YeiGonzalez/Project1_power_supply/README.md

# Project1_power_supply
This project contains the main file for the altium project for the LAB power supply
