YeiGonzalez/Project1_power_supply/Documentacion/HBLD_Fuente_Multisalida.drawio.png

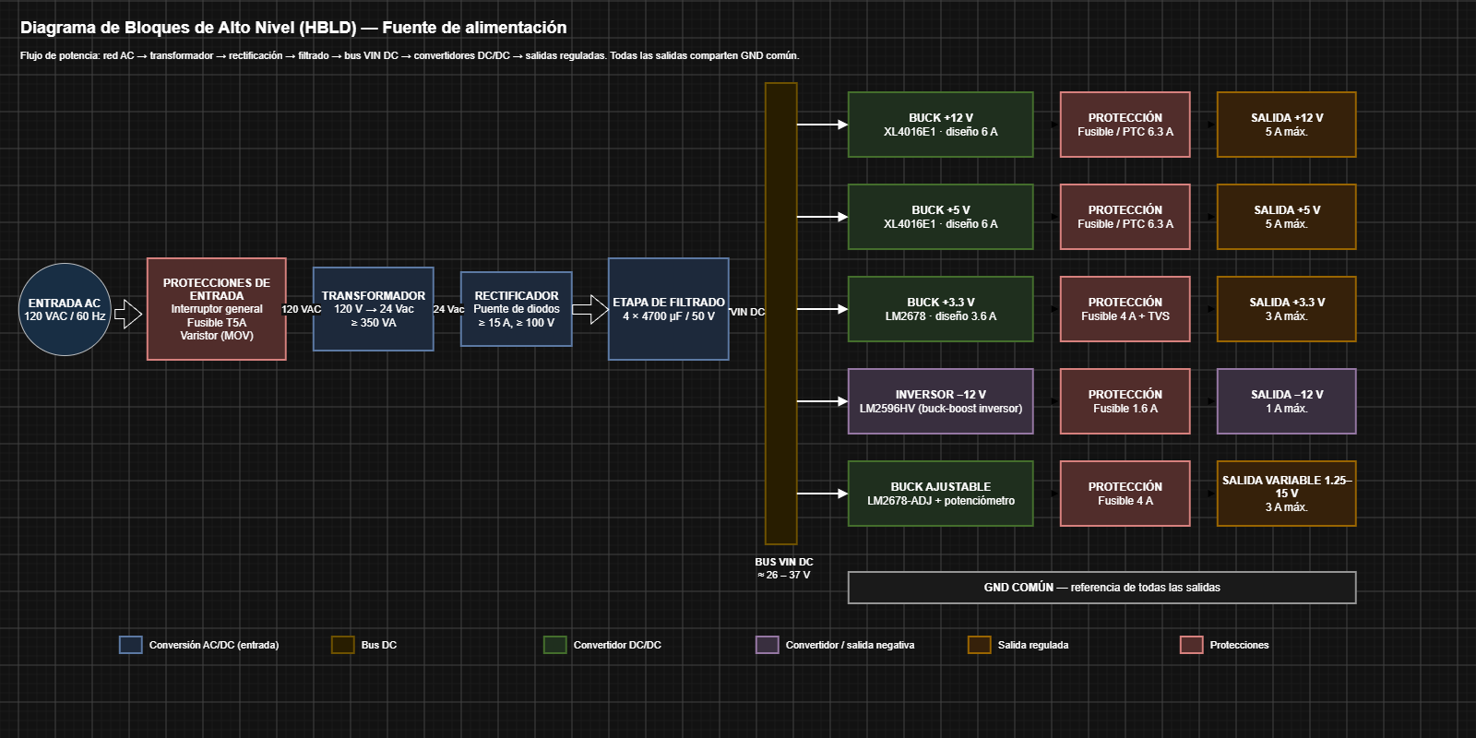
Documentacion/HBLD_Fuente_Multisalida.drawio.png
