YeiGonzalez/Project1_power_supply/Documentacion/HBLD_fuente_multisalida.png

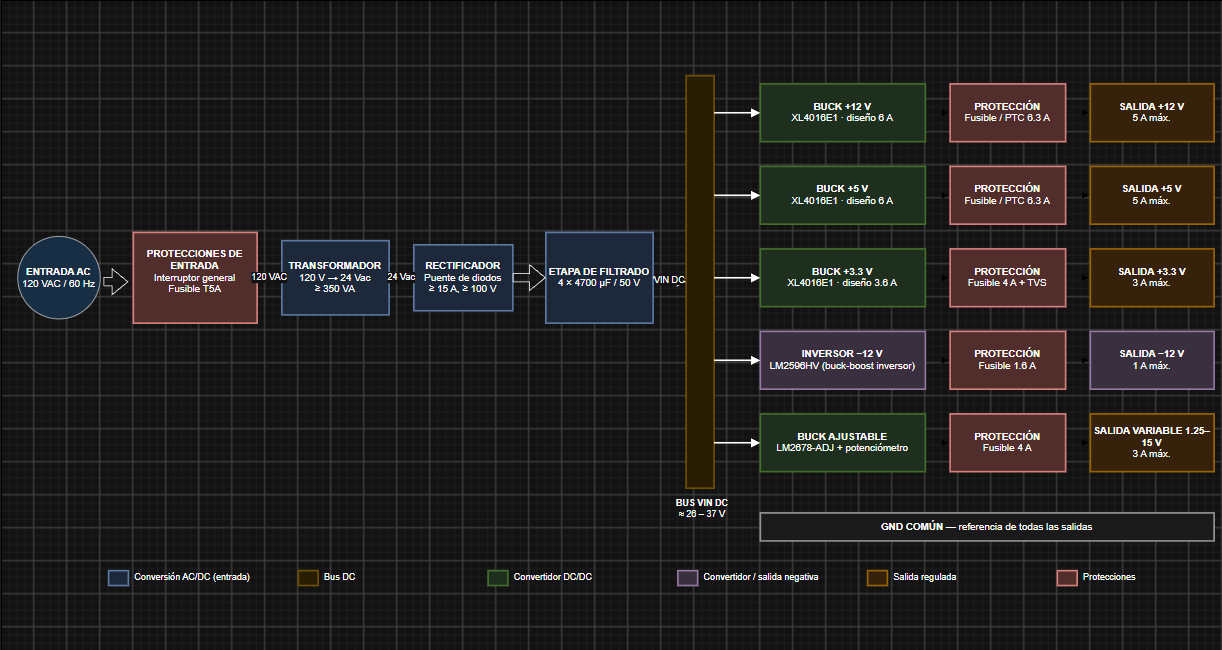
Documentacion/HBLD_fuente_multisalida.png
