YeiGonzalez/Project1_power_supply/Templates/BOM_Template_Atherion.xlsx

Project: | Field=GlobalProjectName |  | Company: | Platia
Board: | Field=GlobalBoardName |  | Date: | Field=GlobalReleaseDate
Revision: | Field=GlobalRevisionVersion |  | Total Quantity: | Field=TotalQuantity
Assembly Variant: | Field=VariantName
Column=Quantity | Column=Designator | Column=Description | Column=Value | Column=Comment | Column=Manufacturer | Column=Manufacturer Part Number | Column=Supplier 1 | Column=Supplier Part Number 1
