YeiGonzalez/Project1_power_supply/Documentacion/Documentacion_Fuente_Multisalida.xlsx

Sheet: Especificaciones
Especificaciones del proyecto — Fuente de alimentación multisalida para laboratorio
1. Información general
Proyecto | Fuente de alimentación multisalida para laboratorio
Asignatura / programa | Diseño y prototipado electronico — Ingeniería Mecatrónica, 2026-2
Objetivo | Diseñar, fabricar y validar una fuente de alimentación de múltiples salidas (+12 V, +5 V, +3.3 V, −12 V y una salida variable) para alimentar proyectos electrónicos de laboratorio.
Alcance | Captura esquemática (Altium Designer), diseño de PCB y fabricación mediante termotransferencia; conversión DC/DC integrada en la PCB.
Nombre | Yeison Eduardo Gonzalez
Versión / fecha | v0.1 — 01/10/2026
2. Entrada de la fuente
Etapa | Descripción
Fuente primaria | Transformador AC del laboratorio
Rectificación | Puente de diodos
Filtrado | Filtrado capacitivo
Conversión | Conversión DC/DC integrada en la PCB
3. Salidas de la fuente
Salida | Tensión nominal (V) | Corriente máxima (A) | Potencia máx. (W) | Conversión prevista (preliminar)
+12 V | 12 | 5 | 60.0 | Convertidor Buck
+5 V | 5 | 5 | 25.0 | Convertidor Buck
+3.3 V | 3.3 | 3 | 9.9 | Convertidor Buck
−12 V | -12 | 1 | 12.0 | Convertidor inversor (Buck-Boost inversor)
Salida variable (1.25–15 V) | 1.25 – 15 | 3 | 45.0 | Convertidor Buck ajustable (potenciómetro)
Potencia total de salida (todas a plena carga) |  |  | 151.9

Sheet: Req Funcionales
Requerimientos funcionales
ID | Requerimiento | Descripción / criterio | Prioridad | Verificación
RF-01 | Alimentación de entrada | Transformador AC de laboratorio con secundario de 24 Vac y potencia ≥ 353 VA (incluye margen del 20%). Si el transformador disponible es menor, se debe limitar la carga total simultánea. | Esencial | Medir tensión del secundario; revisar placa de características
RF-02 | Protección y encendido de entrada | Interruptor general (≥ 250 VAC) y fusible retardado en el primario (≥ 4.4 A, valor comercial superior). Cableado de red fuera de la PCB. | Esencial | Inspección y prueba de continuidad
RF-03 | Rectificación | Puente de diodos de onda completa con corriente ≥ 14 A (2× la corriente DC del bus) y tensión inversa ≥ 100 V, con disipador. | Esencial | Medir tensión DC tras el puente
RF-04 | Filtrado capacitivo | Banco de capacitores electrolíticos de bajo ESR con capacidad total ≥ 14,172 µF y tensión nominal ≥ 50 V. Resistencia de descarga en paralelo. | Esencial | Medir rizado del bus a plena carga
RF-05 | Bus de alimentación VIN DC | Bus DC entre 26 V (carga plena, red baja) y 37 V (sin carga, red alta), que alimenta todos los convertidores. Ancho de pista según hoja 'Cálculos'. | Esencial | Medir VIN en vacío y con carga
RF-06 | Salida +12 V / 5 A | Convertidor Buck (reductor) dimensionado para ≥ 6 A (5 A + 20 % de margen). | Esencial | Carga de 5 A, medir tensión y temperatura
RF-07 | Salida +5 V / 5 A | Convertidor Buck (reductor) dimensionado para ≥ 6 A (5 A + 20 % de margen). | Esencial | Carga de 5 A, medir tensión y temperatura
RF-08 | Salida +3.3 V / 3 A | Convertidor Buck (reductor) dimensionado para ≥ 3.6 A (3 A + 20 % de margen). | Esencial | Carga de 3 A, medir tensión y temperatura
RF-09 | Salida −12 V / 1 A | Convertidor inversor (Buck-Boost inversor) para ≥ 1.2 A; la tensión negativa comparte la referencia GND común. | Esencial | Carga de 1 A, medir polaridad y tensión
RF-10 | Salida variable 1.25–15 V / 3 A | Convertidor Buck ajustable con potenciómetro multivuelta, dimensionado para ≥ 3.6 A (3 A + 20 % de margen). Se descarta regulador lineal por disipación excesiva. | Esencial | Barrido de tensión y carga de 3 A
RF-11 | Referencia común (GND) | Todas las salidas comparten un GND común; GND de potencia y de señal unidos en un solo punto. | Esencial | Continuidad entre bornes GND
RF-12 | Protección de salidas | Limitación de corriente y protección térmica del CI convertidor, más fusible o PTC por salida. Protección contra sobretensión (TVS/zener) en los rieles sensibles (3.3 V). | Esencial | Prueba de cortocircuito controlada
RF-13 | Conectores de salida | Bornes con capacidad ≥ 6 A, identificados por riel (+12 V, +5 V, +3.3 V, −12 V, VAR, GND). | Esencial | Inspección y prueba de continuidad
RF-14 | Indicación de estado | LED indicador por cada riel de salida. | Deseable | Inspección visual
RF-15 | Puntos de prueba | Punto de prueba para VIN DC y para cada salida. | Deseable | Inspección visual
RF-16 | Lectura de la salida variable | Voltímetro de panel o display para la salida variable. | Deseable | Comparar con multímetro

Sheet: Req No Funcionales
Requerimientos no funcionales
ID | Categoría | Requerimiento | Criterio / verificación | Prioridad
RNF-01 | Estética | Disposición ordenada de bornes y controles; serigrafía legible con nombre de rieles y polaridad; bornes con código de colores consistente; acabado limpio de la PCB y del montaje. | Revisión visual por el grupo y docente | Deseable
RNF-02 | Tamaño | Dimensiones de la PCB compatibles con la placa virgen disponible y con la caja/montaje. Dimensión máxima: [completar]. | Medir PCB terminada | Esencial
RNF-03 | Costo | Presupuesto máximo: [completar]. Preferir componentes comerciales de fácil consecución. | BOM con costos | Esencial
RNF-04 | Eficiencia | Eficiencia global ≥ 80 % a plena carga (la hoja 'Cálculos' estima ~85 % con los supuestos actuales). | Medir potencia de entrada vs. salida | Deseable
RNF-05 | Gestión térmica | Temperatura de disipadores ≤ 70 °C a plena carga con ambiente de 25 °C (valor propuesto). Disipadores y, si es necesario, ventilador. | Termómetro / termopar tras 1 h a plena carga | Esencial
RNF-06 | Confiabilidad | Operación continua a plena carga durante ≥ 1 h sin falla ni disparo de protecciones. | Prueba de estrés | Esencial
RNF-07 | Seguridad eléctrica | La tensión de red solo llega al interruptor, fusible y transformador (fuera de la PCB); la PCB trabaja con baja tensión. Zonas con tensión de red aisladas y cubiertas. | Inspección antes de energizar | Esencial
RNF-08 | Calidad de salida | Rizado ≤ 100 mVpp y exactitud ± 5 % en todas las salidas (valores propuestos). | Osciloscopio y multímetro | Esencial
RNF-09 | Compatibilidad EMI | Lazos de conmutación cortos, separación entre sección de potencia y salidas, plano/pista de GND amplia. | Revisión de layout | Deseable
RNF-10 | Manufacturabilidad | Diseño compatible con termotransferencia: componentes through-hole o SMD de paso amplio, pistas y separaciones según hoja 'Restricciones'. | Revisión DRC en Altium y prueba de transferencia | Esencial
RNF-11 | Mantenibilidad | Fusibles reemplazables, componentes de potencia accesibles, designadores claros en serigrafía. | Inspección | Deseable
RNF-12 | Documentación | Esquemáticos, diagrama de bloques, árbol de potencia, BOM y datasheets organizados en el repositorio git (Documentation/Datasheets). | Revisión del repositorio | Esencial
RNF-13 | Usabilidad | Salida variable fácil de ajustar y de leer; rieles identificados para evitar conexiones erróneas. | Prueba de uso | Deseable

Sheet: Restricciones
Restricciones de diseño
ID | Tipo | Restricción | Impacto | Mitigación / decisión
RD-01 | Fabricación | PCB fabricada por termotransferencia: anchos de pista y separaciones mínimas limitados (propuesto ≥ 0.5 mm en pistas de potencia y ≥ 0.4 mm de separación), sin vías metalizadas. | Limita el uso de SMD pequeños y de doble cara. | Usar through-hole o SMD de paso amplio (TO-220, TO-263, SOIC); puentes con cable o remaches en lugar de vías.
RD-02 | Corriente en pistas | Pistas de 5 A y bus de ~7 A con cobre de 1 oz exigen anchos de varios milímetros. | Aumenta el tamaño de la PCB. | Pistas anchas, refuerzo con estaño o cable, planos de cobre amplios; reducir lazos de potencia.
RD-03 | Entrada | La entrada es un transformador AC de laboratorio de potencia limitada. Se requieren ≥ 353 VA para todas las salidas a plena carga simultánea. | Si el transformador es menor, no se puede usar toda la potencia a la vez. | Confirmar datos del transformador; si es necesario, limitar corriente total o reducir salidas simultáneas.
RD-04 | Rango de tensión del bus | El bus DC varía entre ~26 V y ~37 V. Los CI convertidores deben soportar ≥ 40 V de entrada (el inversor, ≥ 49 V entre pines). | Reduce los CI candidatos. | Seleccionar CI de 40 V (o versión HV de 60 V para el inversor).
RD-05 | Disipación térmica | Con eficiencias estimadas se disipan ~27 W a plena carga. | Requiere disipadores y espacio de ventilación. | Disipadores en puente y convertidores, ventilador opcional, separar fuentes de calor.
RD-06 | Margen de diseño | Dimensionar con margen de seguridad de 20–30 % sobre la corriente máxima (se usa 20 %). | Los CI de 5 A no alcanzan para las salidas de 5 A. | Usar CI de ≥ 8 A en +12 V y +5 V.
RD-07 | Seguridad | Se trabaja con red de 120 VAC en el primario del transformador. | La parte de red debe quedar fuera de la PCB. | Fusible, interruptor y cableado de red aislados; energizar solo tras inspección.
RD-08 | Disponibilidad de componentes | Componentes disponibles en tiendas nacionales (I+D Electrónica, Sigma Electrónica, Vistronica, Ferretrónica) o importables (Digi-Key, Mouser, LCSC, Octopart). | Tiempos de entrega e importación. | Verificar existencias antes de fijar la lista; tener alternativa por bloque.
RD-09 | Presupuesto | Presupuesto disponible: [completar]. | Condiciona selección de componentes y conectores. | Registrar costo por componente en la BOM.
RD-10 | Tiempo | Fecha de entrega / cronograma: [completar]. | Limita iteraciones de PCB. | Planificar una sola iteración de PCB con revisión previa.
RD-11 | Espacio y mecánica | Dimensiones de PCB, caja y montaje de conectores: [completar]. | Condiciona colocación de bornes y disipadores. | Definir la caja antes del layout.
RD-12 | Temperatura de operación | Operación en ambiente de laboratorio (propuesto 15–35 °C). | Define el derating térmico. | Seleccionar componentes con rango comercial o superior.
RD-13 | Herramientas y organización | Diseño en Altium Designer; proyecto en repositorio git con carpetas Documentación, PCB/Altium 'Trunk' y Librerías de Altium. | Todo archivo debe versionarse en esa estructura. | Crear el repositorio y la estructura antes de iniciar el esquemático.
RD-14 | Costo, volumen y manufactura (DFM) | Prototipo único; el diseño debe ser fabricable con los medios del laboratorio. | Evita componentes que requieran reflow o equipos especiales. | Revisión DFM antes de imprimir la PCB.

Sheet: Componentes
Lista preliminar de componentes principales
# | Bloque | Componente candidato | Encapsulado | Justificación preliminar | Observaciones / alternativa | Estado
1 | Interruptor general | Interruptor basculante ≥ 250 VAC, ≥ 10 A | Panel / chasis | Corte de red; capacidad superior a la corriente del primario. | Corriente primaria estimada ≈ 2.9 A. | Preliminar
2 | Fusible de entrada | Fusible retardado 5x20 mm, 250 V, T5A (≥ 4.4 A) | Portafusible de panel | Protege el primario; retardado por la corriente de arranque del transformador. | Valor comercial superior al mínimo calculado. | Preliminar
3 | Transformador de entrada | Transformador AC 24 Vac, ≥ 353 VA (toroidal o laminado) | Chasis | Entrega la tensión secundaria que alimenta el bus; el laboratorio provee el transformador. | Verificar corriente secundaria ≥ 12 A rms. | Por confirmar con laboratorio
4 | Puente rectificador | KBPC1510 o equivalente (15 A, 1000 V) | Metálico con disipador | Corriente ≥ 2× la corriente DC del bus; tensión inversa muy superior al pico. | Montar en disipador. | Preliminar
5 | Capacitores de filtrado | 4 × 4700 µF / 50 V electrolíticos de bajo ESR | Radial / snap-in | Capacidad total ≥ 14,172 µF; 50 V da margen sobre 37 V. | Verificar corriente de rizado admisible. | Preliminar
6 | Resistencia de descarga | 2.2 kΩ / 2 W | Axial | Descarga el banco de capacitores al apagar. | Verificar potencia disipada. | Preliminar
7 | Convertidor Buck +12 V | XL4016E1 (8 A, entrada hasta 40 V) | TO-263-5 | Corriente de 8 A cubre 5 A + margen; encapsulado de paso amplio apto para termotransferencia. | Alternativa: controlador Buck con MOSFET externo. | Por validar con datasheet
8 | Convertidor Buck +5 V | XL4016E1 (8 A, entrada hasta 40 V) | TO-263-5 | Igual que +12 V; mismo CI reduce el número de referencias. | Alternativa: módulo Buck de ≥ 8 A. | Por validar con datasheet
9 | Convertidor Buck +3.3 V | XL4016E1 (8 A, entrada hasta 40 V) | TO-263-5 | 5 A cubre 3 A + margen; encapsulado through-hole. | Alternativa: LM2596 (3 A, sin margen). | Por validar con datasheet
10 | Convertidor −12 V | LM2596HV-ADJ en configuración inversora (60 V) | TO-263-5 / TO-220-5 | Versión HV soporta la tensión del bus más 12 V entre pines. | Validar corriente de salida inversora ≥ 1.2 A con curvas del datasheet. | Por validar con datasheet
11 | Regulador de tensión variable | LM2678T-ADJ + potenciómetro multivuelta 10 kΩ | TO-220-7 | Salida ajustable desde ~1.2 V; 5 A cubre 3 A + margen. | Se descarta LM317 por límite de corriente y disipación. | Por validar con datasheet
12 | Inductores de los convertidores | Inductores de potencia toroidales (valor y corriente de saturación según datasheet de cada CI) | Through-hole | Corriente de saturación ≥ 1.3× la corriente pico de diseño. | Calcular L con las ecuaciones de cada datasheet. | Por calcular
13 | Diodos Schottky de recirculación | Schottky 60 V, ≥ 10 A para +12 V/+5 V (p. ej. MBR1060); ≥ 5 A para +3.3 V y variable; ≥ 3 A para −12 V | TO-220 | Los CI son no síncronos; el diodo debe soportar el bus de entrada. | Verificar tensión inversa ≥ 49 V en el inversor. | Preliminar
14 | Capacitores de entrada/salida de convertidores | Electrolíticos bajo ESR 25–50 V + cerámicos 100 nF | Radial / 0805 | Estabilizan los convertidores y reducen el rizado. | Valores según datasheet de cada CI. | Por calcular
15 | Protección de salida | Fusible o PTC por salida (≈ 6.3 A en +12/+5 V, 4 A en +3.3 V y variable, 1.6 A en −12 V) y TVS en el riel de 3.3 V | Portafusible / SMD | Protege cargas y fuente ante cortocircuito o sobretensión. | Ajustar valores tras validar corrientes de diseño. | Preliminar
16 | Conectores de salida | Bornes de panel (tipo banana) ≥ 10 A, uno por riel + GND | Panel | Soportan 5 A con margen. | Código de colores por riel. | Preliminar
17 | Conectores de PCB | Bornera de tornillo 5.08 mm ≥ 15 A (entrada AC y salidas) | Through-hole | Conexión robusta entre PCB y cables de potencia. | Verificar paso y corriente. | Preliminar

Sheet: Cálculos
Cálculos de soporte — presupuesto de potencia y dimensionamiento
A. Supuestos (editar)
Tensión del secundario del transformador (Vac rms) | 24 | V | Propuesto; confirmar con transformador del laboratorio
Frecuencia de red | 60 | Hz | Red en Colombia: 60 Hz
Tensión nominal de red | 120 | V | Red monofásica en Colombia: 120 V
Tolerancia alta combinada (red + regulación en vacío) | 15% |  | Supuesto del grupo
Tolerancia baja de red | 10% |  | Supuesto del grupo
Caída por diodo del puente | 1.1 | V | Valor típico; confirmar en datasheet
Rizado pico a pico permitido en el bus | 4 | V | Supuesto del grupo
Factor corriente RMS secundario / corriente DC | 1.8 |  | Regla práctica para rectificador con filtro capacitivo
Margen de seguridad de corriente | 20% |  | Diapositivas del curso: 20–30 %
Espesor de cobre | 1 | oz | Placa virgen estándar de 1 oz (confirmar)
Aumento de temperatura permitido en pistas | 10 | °C | Supuesto; fórmula IPC-2221 (capa externa)
Ancho mínimo práctico de pista (termotransferencia) | 0.5 | mm | Supuesto del grupo
Holgura mínima VIN sobre la salida máxima | 3 | V | Supuesto; validar con dropout del CI
B. Bus DC (VIN)
Tensión pico nominal del secundario | 33.9 | V
VIN máximo (sin carga, red alta) | 36.8 | V
VIN mínimo (carga plena, red baja, con rizado) | 26.3 | V
Verificación: VIN máx ≤ 40 V (CI convertidores) | OK
Verificación: VIN mín ≥ 15 V + holgura (salida variable) | OK
Verificación: VIN máx + 12 V ≤ 60 V (inversor, versión HV) | OK
C. Presupuesto de potencia por salida
Salida | Vout (V) | Imáx (A) | I diseño (A) | Pout (W) | Eficiencia supuesta | Pin (W) | I del bus (A) | Ancho de pista salida (mm) | Observación
+12 V | 12 | 5 | 6.00 | 60.0 | 88% | 68.2 | 2.59 | 3.56 | Buck
+5 V | 5 | 5 | 6.00 | 25.0 | 85% | 29.4 | 1.12 | 3.56 | Buck
+3.3 V | 3.3 | 3 | 3.60 | 9.9 | 78% | 12.7 | 0.48 | 1.76 | Buck
−12 V | -12 | 1 | 1.20 | 12.0 | 75% | 16.0 | 0.61 | 0.50 | Inversor; Pout con |Vout
Variable (1.25–15 V) | 15 | 3 | 3.60 | 45.0 | 85% | 52.9 | 2.01 | 1.76 | Pout calculada con 15 V (máximo)
TOTAL |  |  |  | 151.9 | 84.8% | 179.2 | 6.80 |  | Eficiencia global estimada
Potencia disipada total (W) |  |  |  | 27.3
D. Dimensionamiento de la etapa de entrada
Corriente DC del bus a plena carga (A) | 6.80
Capacidad mínima de filtrado (µF) | 14171.99452
Corriente RMS del secundario (A) | 12.2
Potencia aparente mínima del transformador (VA) | 293.8704783
Potencia aparente recomendada con margen (VA) | 352.644574
Corriente del primario (A) | 2.94
Fusible primario mínimo, 1.5× (A) | 4.4
Corriente mínima del puente rectificador, 2× (A) | 13.6
Ancho de pista del bus VIN (mm) | 5.4
Notas: (1) El ancho de pista usa la ecuación IPC-2221 para capa externa. (2) El cálculo supone todas las salidas a plena carga simultánea (peor caso). (3) Las eficiencias son supuestos; sustituir por las curvas de los datasheets.
