YeiGonzalez/Project1_power_supply/Templates/BOM_Template.xlsx

Field=GlobalProjectName | Field=ProjectFileName
Description | Designator | MFG | MFG PN | Supplier | Supplier PN | QTY | Usage
Column=Description | Column=Designator | Column=Manufacturer | Column=Manufacturer Part Number | Column=Supplier 1 | Column=Supplier Part Number 1 | Column=Quantity | Column=Usage
