YeiGonzalez/Project1_power_supply/(list of files, drawings)

Other design files:
PCB/Trunk/000_Hierarchical.SchDoc
PCB/Trunk/100_AC-DC.SchDoc
PCB/Trunk/200_DC-DC.SchDoc
PCB/Trunk/300_DC-DC.SchDoc
PCB/Trunk/Main_PCB_V1R0_XXXXXX.PcbDoc
PCB/Trunk/Project power supply.PrjPCB
Templates/Def_PCB.PcbDoc
Templates/Def_project.PrjPCB
Templates/Def_sch.SchDoc
