YeiGonzalez/Project1_power_supply/(commit log)

2026-09-26 initial structure: PCB/Trunk y Documentacion
2026-09-26 correction initial structure: PCB/Trunk y Documentacion
2026-10-02 Agregar carpeta Templates
    [BOM_Template.xlsx, BOM_Template_Atherion.xlsx, Def_PCB.PcbDoc, Def_project.PrjPCB, Def_sch.SchDoc]
2026-10-02 Agrega documentación inicial: HBLD y Excel
    [Documentacion_Fuente_Multisalida.xlsx]
